jgobat/controller/README.md

# controller

Main control board for simple buoyancy driven underwater vehicles. Based around Teensy 3.6.
