jgobat/controller/kicad/floatController_Digikey_BOM.ods

Ref | Qnty | Value | Cmp name | Footprint | Description | Digikey
B1, | 1 | Battery_Cell | Battery_Cell | Battery:BatteryHolder_Keystone_3002_1x2032 | Single-cell battery | 36-3002-ND
C1, | G | 10u | C-EUC1210 | Capacitor_SMD:C_1206_3216Metric_Pad1.42x1.75mm_HandSolder |  | 490-4798-1-ND‎
C2, | 1 | 22u | C-EUC1210 | Capacitor_SMD:C_1206_3216Metric_Pad1.42x1.75mm_HandSolder |  | 490-4797-1-ND‎
C3, | 1 | 10u | C-EUC0805 | Capacitor_SMD:C_0805_2012Metric_Pad1.15x1.40mm_HandSolder |  | 490-10514-1-ND‎
C4, | 1 | 4.7u | C-EUC0805 | Capacitor_SMD:C_0603_1608Metric_Pad1.05x0.95mm_HandSolder |  | 490-16347-1-ND
C5, C6, C7, C8, C9, C10, C11, C12, C13, C15, C16, C17, C18, C20, C22, | 15 | 0.1u | C | Capacitor_SMD:C_0603_1608Metric_Pad1.05x0.95mm_HandSolder | Unpolarized capacitor | 490-16477-1-ND
C14, | 1 | 22u | C | Capacitor_SMD:C_0603_1608Metric_Pad1.05x0.95mm_HandSolder | Unpolarized capacitor | 490-13243-1-ND
C19, C23, | 2 | 10n | C | Capacitor_SMD:C_0603_1608Metric_Pad1.05x0.95mm_HandSolder | Unpolarized capacitor | 490-8028-1-ND
C21, | 1 | 39u | CP1 | Capacitor_SMD:CP_Elec_5x5.9 | Polarized capacitor, US symbol | P124997CT-ND
J1, | 1 | Molex_KK156_2 | MTA02-156 | Connector_Molex:Molex_KK-396_A-41791-0002_1x02_P3.96mm_Vertical |  | WM18823-ND
J2, J6, J9, | 3 | Molex_KK100_4 | Conn_01x04 | Connector_Molex:Molex_KK-254_AE-6410-04A_1x04_P2.54mm_Vertical | Generic connector, single row, 01x04, script generated (kicad-library-utils/schlib/autogen/connector/) | WM4202-ND
J3, J5, | 2 | Molex_KK100_6 | Conn_01x06 | Connector_Molex:Molex_KK-254_AE-6410-06A_1x06_P2.54mm_Vertical | Generic connector, single row, 01x06, script generated (kicad-library-utils/schlib/autogen/connector/) | WM4204-ND
J4, | 1 | Hirose_DF11_2x8 | Conn_01x16 | Connector_Hirose:Hirose_DF11-16DP-2DSA_2x08_P2.00mm_Vertical | Generic connector, single row, 01x16, script generated (kicad-library-utils/schlib/autogen/connector/) | H2856-ND
J7, | 1 | PinSocket_2.54mm_4 | Conn_01x04 | Connector_PinSocket_2.54mm:PinSocket_1x04_P2.54mm_Vertical | Generic connector, single row, 01x04, script generated (kicad-library-utils/schlib/autogen/connector/)
J8, J11, J14, | 3 | Molex_KK100_3 | Conn_01x03 | Connector_Molex:Molex_KK-254_AE-6410-03A_1x03_P2.54mm_Vertical | Generic connector, single row, 01x03, script generated (kicad-library-utils/schlib/autogen/connector/) | WM13451-ND
J10, | 1 | Molex_KK100_2 | Conn_01x02 | Connector_Molex:Molex_KK-254_AE-6410-02A_1x02_P2.54mm_Vertical | Generic connector, single row, 01x02, script generated (kicad-library-utils/schlib/autogen/connector/) | WM13450-ND
J12, | 1 | JST_SH_4_Horz | Conn_01x04 | Connector_JST:JST_SH_SM04B-SRSS-TB_1x04-1MP_P1.00mm_Horizontal | Generic connector, single row, 01x04, script generated (kicad-library-utils/schlib/autogen/connector/) | 455-1804-1-ND
J13, J15, | 2 | Hirose_DF11_2x2 | Conn_01x04 | Connector_Hirose:Hirose_DF11-4DP-2DSA_2x02_P2.00mm_Vertical | Generic connector, single row, 01x04, script generated (kicad-library-utils/schlib/autogen/connector/) | H122036-ND
J16, | 1 | Hirose_DF11_2x3 | Conn_01x06 | Connector_Hirose:Hirose_DF11-6DP-2DSA_2x03_P2.00mm_Vertical | Generic connector, single row, 01x06, script generated (kicad-library-utils/schlib/autogen/connector/) | H10230-ND
J17, | 1 | JST_SH_4_Vert | Conn_01x04 | Connector_JST:JST_SH_BM04B-SRSS-TB_1x04-1MP_P1.00mm_Vertical | Generic connector, single row, 01x04, script generated (kicad-library-utils/schlib/autogen/connector/) | 455-1790-1-ND
J18, | 1 | JST_SH_3_Vert | Conn_01x03 | Connector_JST:JST_SH_BM03B-SRSS-TB_1x03-1MP_P1.00mm_Vertical | Generic connector, single row, 01x03, script generated (kicad-library-utils/schlib/autogen/connector/) | 455-1789-1-ND
JP1, | 1 | PinHead_2.54mm_2 | PINHD-1X2 | Connector_PinHeader_2.54mm:PinHeader_1x02_P2.54mm_Vertical
JP2, JP3, JP4, JP5, JP6, JP7, JP8, JP9, JP12, JP13, | 10 | PinHead_2.54mm_3 | Conn_01x03_Male | Connector_PinHeader_2.54mm:PinHeader_1x03_P2.54mm_Vertical | Generic connector, single row, 01x03, script generated (kicad-library-utils/schlib/autogen/connector/)
JP10, JP11, JP14, | 3 | 0.003 0603 | Conn_01x03_Male | teensy_100:R0603_3position_jumper | Generic connector, single row, 01x03, script generated (kicad-library-utils/schlib/autogen/connector/)
MT1, MT2, MT3, MT4, | 4 | MountingHole | MountingHole | MountingHole:MountingHole_3mm_Pad | Mounting Hole without connection
Q1, | 1 | DMN3023L-7 | SI2334 | Package_TO_SOT_SMD:SOT-23 |  | DMN3023L-7DICT-ND
Q2, | 1 | SI4497 | SI4497 | Package_SO:SOIC-8_3.9x4.9mm_P1.27mm |  | SI4497DY-T1-GE3CT-ND
Q3, Q4, Q5, Q6, Q7, Q8, Q9, Q10, Q11, | 9 | Si4554DY | Si4532DY | Package_SO:SOIC-8_3.9x4.9mm_P1.27mm | 3.9A Id, 30V Vds, Dual N and P Channel MOSFET, 65mOhm Ron, 10V Vgs, SO8L | SI4554DY-T1-GE3CT-ND
Q12, | 1 | DMG6601LVT | DMC2053UVT | Package_TO_SOT_SMD:TSOT-23-6 | 4.6A/-3.2A Id, 20V Vds, Complementary pair enhancement mode P-Channel and N-Channel MOSFET, TSOT-23-6 | ‎DMG6601LVT-7DICT-ND‎
R1, | 1 | 0.025 | R_Shunt_US | Resistor_SMD:R_Shunt_Ohmite_LVK24 | Shunt resistor, US symbol | LVK24R025DERCT-ND
R2, R3, R4, R6, R7, R8, R9, R10, R11, R12, R13, R14, R15, R16, R17, R18, R19, R26, R27, R28, R29, R31, R32, R45, R46, | 25 | 220k | R_US | Resistor_SMD:R_0603_1608Metric_Pad1.05x0.95mm_HandSolder | Resistor, US symbol | P220KGCT-ND
R5, R38, R39, R40, R41, R42, R43, R44, | 8 | 10k | R_US | Resistor_SMD:R_0603_1608Metric_Pad1.05x0.95mm_HandSolder | Resistor, US symbol | P10KGCT-ND
R20, R21, R22, R23, R24, R25, | 6 | 4.7k | R_US | Resistor_SMD:R_0603_1608Metric_Pad1.05x0.95mm_HandSolder | Resistor, US symbol | P4.7KGCT-ND
R30, | 1 | 0.1 | R_US | Resistor_SMD:R_2512_6332Metric_Pad1.52x3.35mm_HandSolder | Resistor, US symbol | CSRN2512FTR100CT-ND
R33, R34, R35, | 3 | TBD | R_US | Resistor_SMD:R_0603_1608Metric_Pad1.05x0.95mm_HandSolder | Resistor, US symbol
SW1, | 1 | MS-106-3-x | REED-SWITCH-MK6-6 | teensy_100:MK6-6 |  | 2010-1085-ND
TP1, | 1 | +5V | TestPoint | TestPoint:TestPoint_Keystone_5000-5004_Miniature | test point | 36-5000-ND
TP2, | 1 | +3V3 | TestPoint | TestPoint:TestPoint_Keystone_5000-5004_Miniature | test point | 36-5000-ND
TP3, | 1 | GND | TestPoint | TestPoint:TestPoint_Keystone_5000-5004_Miniature | test point | 36-5001-ND
U1, | 1 | TEENSY_3.5_3.6 | TEENSY_3.5_3.6 | teensy_100:TEENSY_3.5_3.6 |  | 1568-1442-ND
U2, | 1 | TINY25 | TINY13PU | Package_DIP:DIP-8_W7.62mm_Socket |  | ATTINY25-20PU-ND
U3, | 1 | LMZM2360X | LMZM2360X | teensy_100:LMZM2360X |  | 296-49462-1-ND
U4, | 1 | TPSM842X | TPSM842X | teensy_100:TPSM842X |  | 296-47074-ND
U5, | 1 | INA233 | TI-INA226 | Package_SO:VSSOP-10_3x3mm_P0.5mm |  | 296-48136-1-ND
U6, U7, | 2 | MAX3221 | MAX3221 | Package_SO:SSOP-16_5.3x6.2mm_P0.65mm | RS232 transceiver with 15kV ESD protection | 296-9595-1-ND
U8, | 1 | LSM9DS1 | LSM9DS1 | Package_LGA:LGA-24L_3x3.5mm_P0.43mm |  | 497-14946-1-ND
U9, | 1 | BME280 | BME280 | Package_LGA:Bosch_LGA-8_2.5x2.5mm_P0.65mm_ClockwisePinNumbering |  | 828-1063-1-ND
U10, | 1 | LTC4311 | LTC4311 | Package_TO_SOT_SMD:SOT-363_SC-70-6_Handsoldering | Simple 2-wire bus buffer | LTC4311ISC6#TRMPBFCT-ND
U11, | 1 | ESP-07 | ESP-07 | teensy_100:ESP-07 | 802.11 b/g/n Wi-Fi Module | ESP-07S-ND
U12, | 1 | TPS709xx | TPS709xx | Package_TO_SOT_SMD:SOT-23-5 |  | ‎296-35483-1-ND‎
U13, U14, | 2 | TB67H451FNG | DRV8870DDA | Package_SO:Texas_HTSOP-8-1EP_3.9x4.9mm_P1.27mm_EP2.95x4.9mm_Mask2.4x3.1mm_ThermalVias | Brushed DC Motor Driver, PWM Control, 45V, 3.6A, Dynamic current limiting, HTSOP-8 | 264-TB67H451FNGELCT-ND
