jgobat/controller/kicad/floatController.kicad_pcb

## KiCad design kicad/floatController.kicad_pcb (2021-12-19)

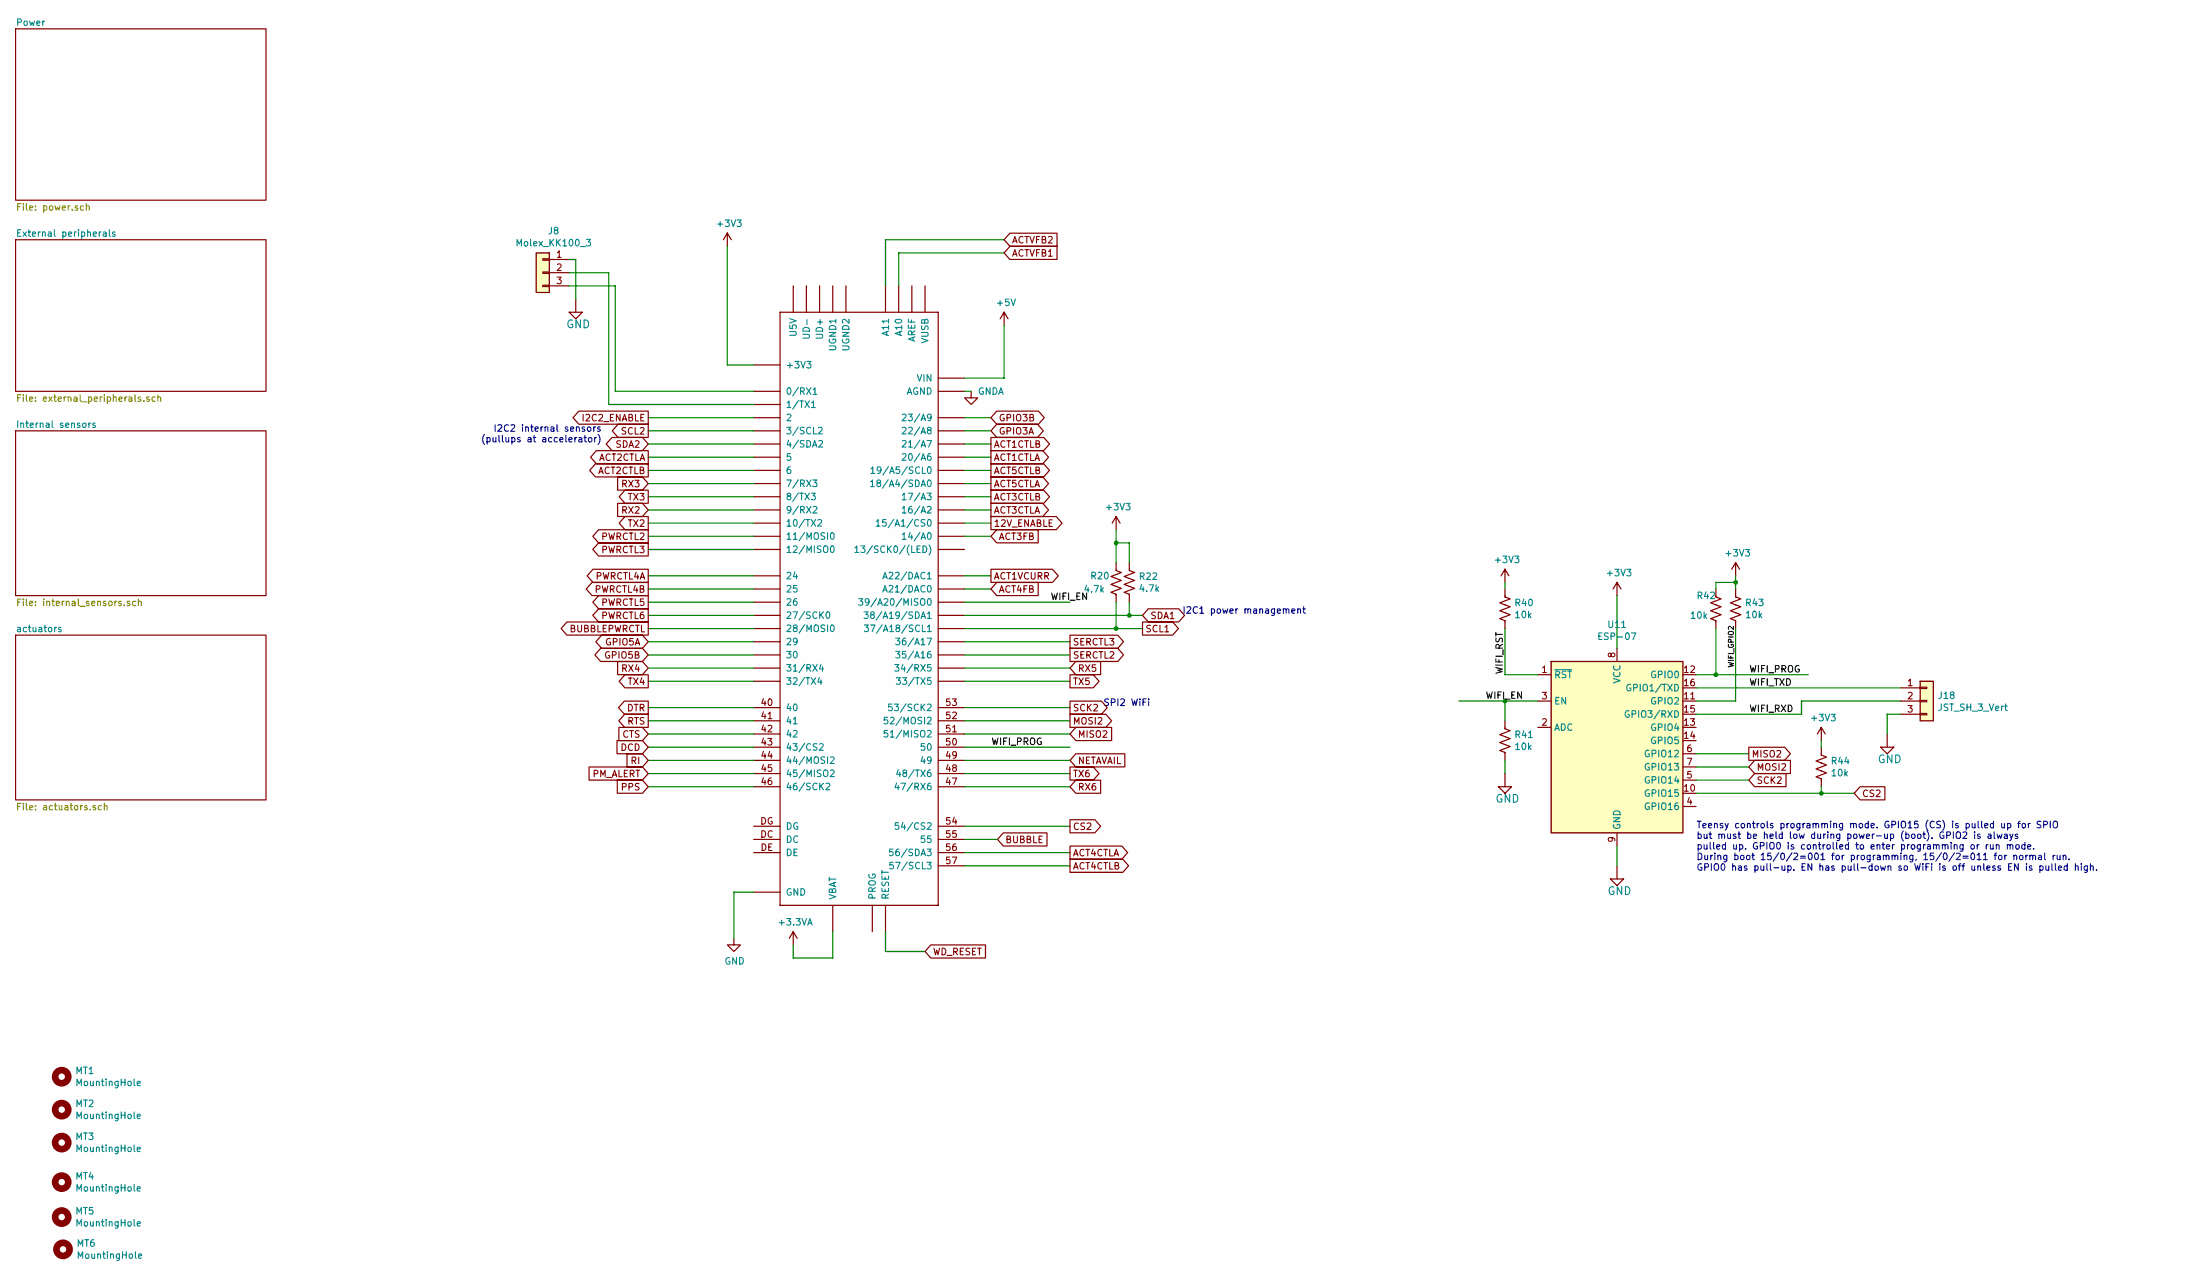
[picture p6: schematic floatController.sch, Float controller]

Parts:
J8: Molex_KK100_3; Molex_KK-254_AE-6410-03A_1x03_P2.54mm_Vertical; Manufacturer pn 0022235031; Digikey WM13451-ND
J18: JST_SH_3_Vert; JST_SH_BM03B-SRSS-TB_1x03-1MP_P1.00mm_Vertical; Manufacturer pn BM03B-SRSS-TB(LF)(SN); Digikey 455-1789-1-ND
MT1, MT2, MT3, MT4: MountingHole; MountingHole_3mm_Pad
MT5, MT6: MountingHole; MountingHole_2.5mm
R20, R22: 4.7k; R_0603_1608Metric_Pad1.05x0.95mm_HandSolder; Rating 5%, 1/10W; Manufacturer pn ERJ-3GEYJ472V; Digikey P4.7KGCT-ND
R40, R41, R42, R43, R44: 10k; R_0603_1608Metric_Pad1.05x0.95mm_HandSolder; Manufacturer pn ERJ-3GEYJ103V; Digikey P10KGCT-ND
U1: TEENSY_3.5_3.6; Digikey 1568-1442-ND
U11: ESP-07; Manufacturer pn ESP-07S; Digikey ESP-07S-ND

Connections:
12V_ENABLE: U1.15 (15/A1/CS0); also elsewhere on the board
+3.3VA: U1.VBAT; also elsewhere on the board
+3V3: R20.1, R22.1, R40.1, R42.1, R43.1, R44.1, U1.3V3 (+3V3), U1.3V3_2, U1.3V3_3, U1.3V3_LO, U11.8 (VCC); also elsewhere on the board
+5V: U1.VIN; also elsewhere on the board
/WIFI_EN: R41.1, U1.39 (39/A20/MISO0), U11.3 (EN)
/WIFI_GPIO2: R43.2, U11.11 (GPIO2)
/WIFI_PROG: R42.2, U1.50, U11.12 (GPIO0)
/WIFI_RST: R40.2, U11.1 (~RST)
/WIFI_RXD: J18.2, U11.15 (GPIO3/RXD)
/WIFI_TXD: J18.1, U11.16 (GPIO1/TXD)
ACT1CTLA: U1.20 (20/A6); also elsewhere on the board
ACT1CTLB: U1.21 (21/A7); also elsewhere on the board
ACT1VCURR: U1.A22 (A22/DAC1); also elsewhere on the board
ACT2CTLA: U1.5; also elsewhere on the board
ACT2CTLB: U1.6; also elsewhere on the board
ACT3CTLA: U1.16 (16/A2); also elsewhere on the board
ACT3CTLB: U1.17 (17/A3); also elsewhere on the board
ACT3FB: U1.14 (14/A0); also elsewhere on the board
ACT4CTLA: U1.56 (56/SDA3); also elsewhere on the board
ACT4CTLB: U1.57 (57/SCL3); also elsewhere on the board
ACT4FB: U1.A21 (A21/DAC0); also elsewhere on the board
ACT5CTLA: U1.18 (18/A4/SDA0); also elsewhere on the board
ACT5CTLB: U1.19 (19/A5/SCL0); also elsewhere on the board
ACTVFB1: U1.A10; also elsewhere on the board
ACTVFB2: U1.A11; also elsewhere on the board
BUBBLE: U1.55; also elsewhere on the board
BUBBLEPWRCTL: U1.28 (28/MOSI0); also elsewhere on the board
CS2: R44.2, U1.54 (54/CS2), U11.10 (GPIO15)
CTS: U1.42; also elsewhere on the board
DCD: U1.43 (43/CS2); also elsewhere on the board
DTR: U1.40; also elsewhere on the board
GND: J8.1, J18.3, R41.2, U1.GND, U1.GND2, U1.GND3, U1.GND4, U1.GND5, U11.9 (GND); also elsewhere on the board
GNDA: U1.AGND; also elsewhere on the board
GPIO3A: U1.22 (22/A8); also elsewhere on the board
GPIO3B: U1.23 (23/A9); also elsewhere on the board
GPIO5A: U1.29; also elsewhere on the board
GPIO5B: U1.30; also elsewhere on the board
I2C2_ENABLE: U1.2; also elsewhere on the board
MISO2: U1.51 (51/MISO2), U11.6 (GPIO12)
MOSI2: U1.52 (52/MOSI2), U11.7 (GPIO13)
NETAVAIL: U1.49; also elsewhere on the board
unnamed: J8.2, U1.1 (1/TX1)
unnamed: J8.3, U1.0 (0/RX1)
PM_ALERT: U1.45 (45/MISO2); also elsewhere on the board
PPS: U1.46 (46/SCK2); also elsewhere on the board
PWRCTL2: U1.11 (11/MOSI0); also elsewhere on the board
PWRCTL3: U1.12 (12/MISO0); also elsewhere on the board
PWRCTL4A: U1.24; also elsewhere on the board
PWRCTL4B: U1.25; also elsewhere on the board
PWRCTL5: U1.26; also elsewhere on the board
PWRCTL6: U1.27 (27/SCK0); also elsewhere on the board
RI: U1.44 (44/MOSI2); also elsewhere on the board
RTS: U1.41; also elsewhere on the board
RX2: U1.9 (9/RX2); also elsewhere on the board
RX3: U1.7 (7/RX3); also elsewhere on the board
RX4: U1.31 (31/RX4); also elsewhere on the board
RX5: U1.34 (34/RX5); also elsewhere on the board
RX6: U1.47 (47/RX6); also elsewhere on the board
SCK2: U1.53 (53/SCK2), U11.5 (GPIO14)
SCL1: R20.2, U1.37 (37/A18/SCL1); also elsewhere on the board
SCL2: U1.3 (3/SCL2); also elsewhere on the board
SDA1: R22.2, U1.38 (38/A19/SDA1); also elsewhere on the board
SDA2: U1.4 (4/SDA2); also elsewhere on the board
SERCTL2: U1.35 (35/A16); also elsewhere on the board
SERCTL3: U1.36 (36/A17); also elsewhere on the board
TX2: U1.10 (10/TX2); also elsewhere on the board
TX3: U1.8 (8/TX3); also elsewhere on the board
TX4: U1.32 (32/TX4); also elsewhere on the board
TX5: U1.33 (33/TX5); also elsewhere on the board
TX6: U1.48 (48/TX6); also elsewhere on the board
WD_RESET: U1.RESET; also elsewhere on the board

Notes on the sheet:
I2C1 power management
I2C2 internal sensors (pullups at accelerator)
SPI2 WiFi
Teensy controls programming mode. GPIO15 (CS) is pulled up for SPIO but must be held low during power-up (boot). GPIO2 is always pulled up. GPIO0 is controlled to enter programming or run mode. During boot 15/0/2=001 for programming, 15/0/2=011 for normal run. GPIO0 has pull-up. EN has pull-down so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

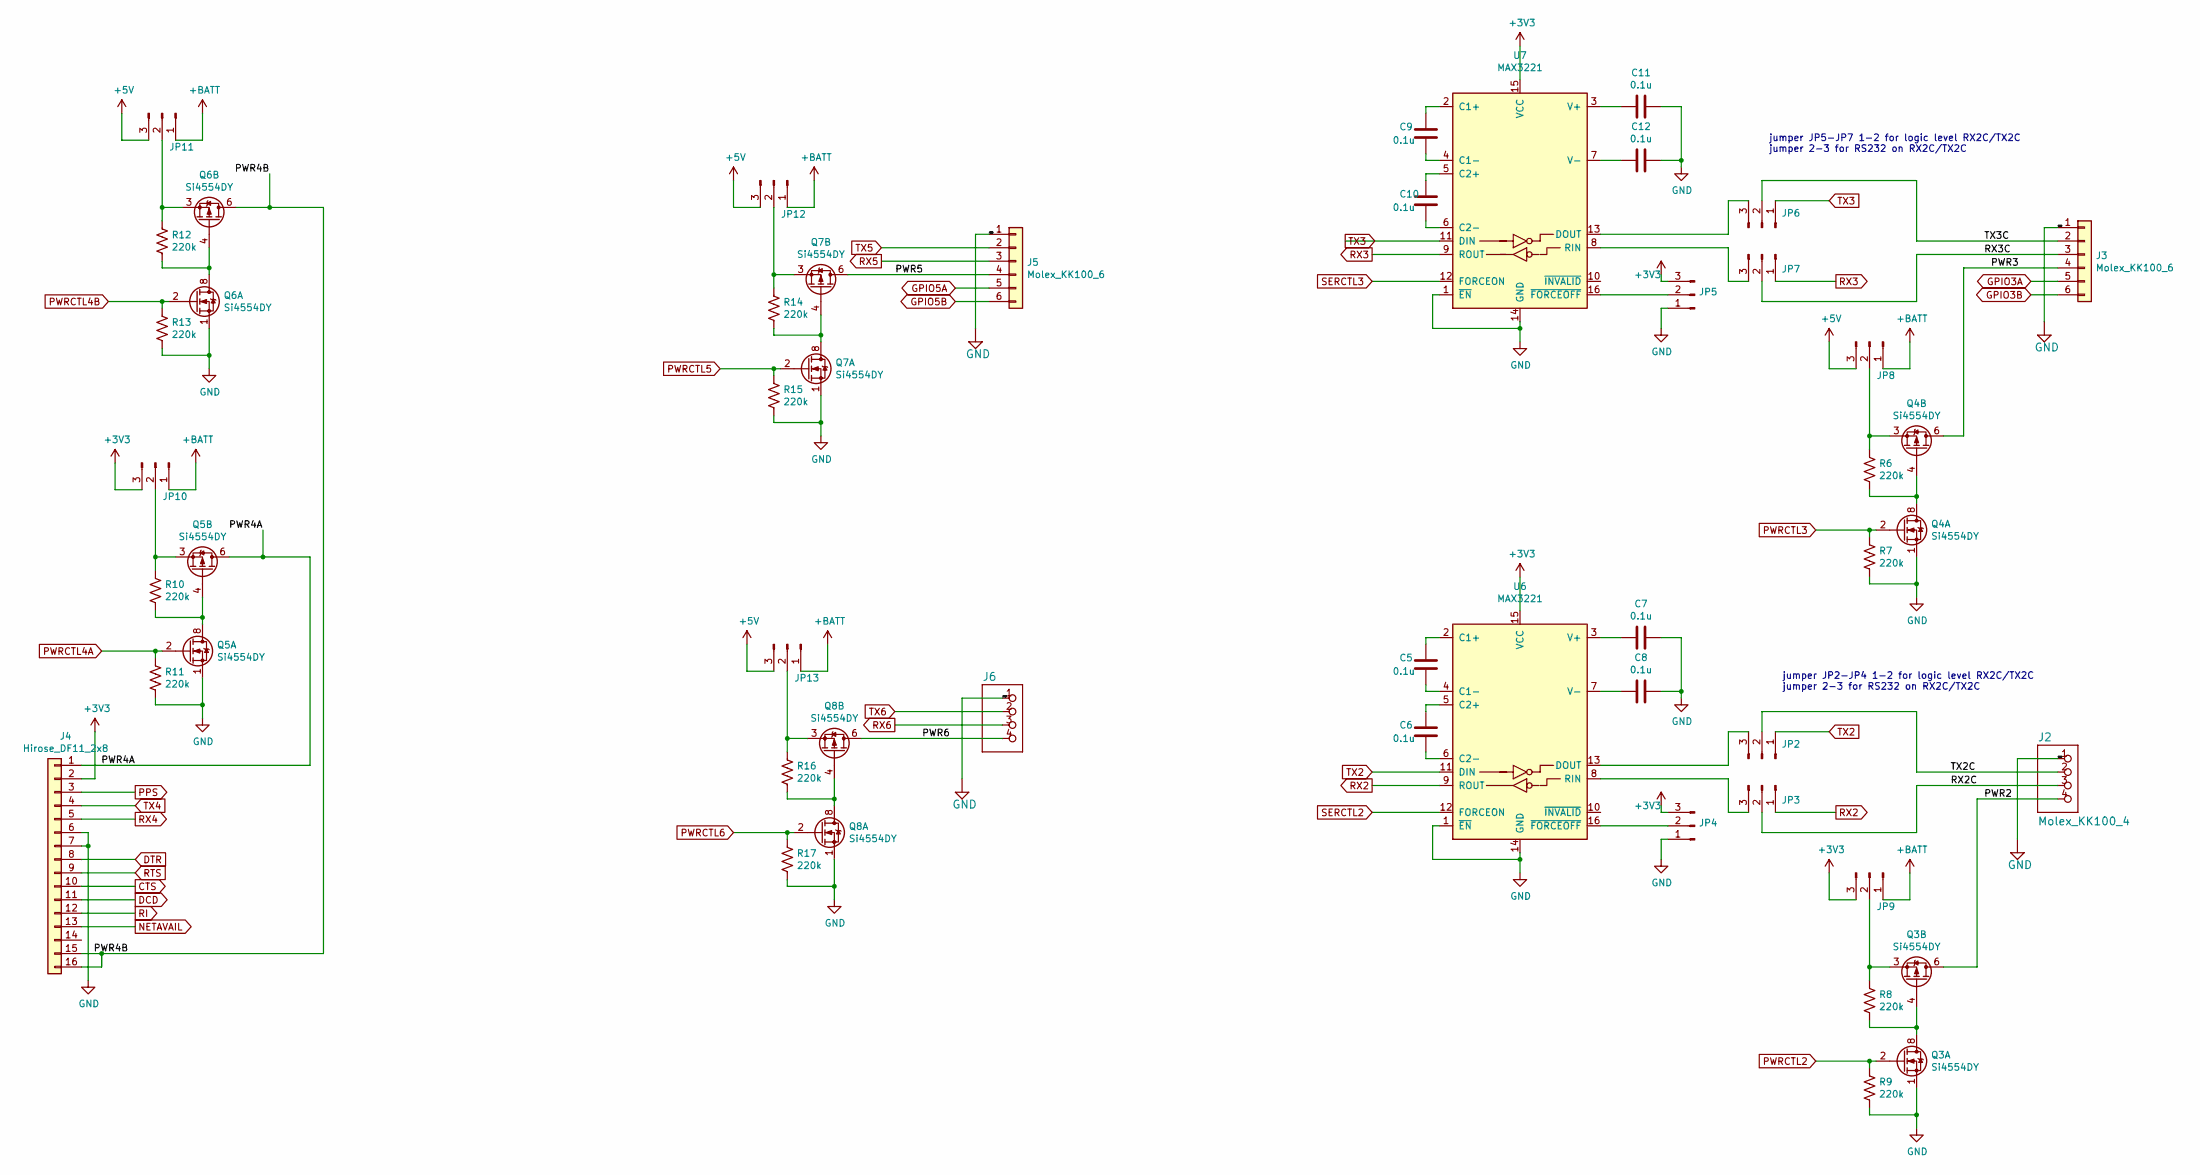
[picture p7: schematic external_peripherals.sch, Float controller]

Parts:
C5, C6, C7, C8, C9, C10, C11, C12: 0.1u; C_0603_1608Metric_Pad1.05x0.95mm_HandSolder; Manufacturer pn GCJ188R71E104KA12D‎; Digikey 490-16477-1-ND
J2, J6: Molex_KK100_4; Molex_KK-254_AE-6410-04A_1x04_P2.54mm_Vertical; Manufacturer pn 0022232041; Digikey WM4202-ND
J3, J5: Molex_KK100_6; Molex_KK-254_AE-6410-06A_1x06_P2.54mm_Vertical; Manufacturer pn 0022232061; Digikey WM4204-ND
J4: Hirose_DF11_2x8; Hirose_DF11-16DP-2DSA_2x08_P2.00mm_Vertical; Manufacturer pn DF11-16DP-2DSA(01); Digikey H2856-ND
JP2, JP3, JP4, JP5, JP6, JP7, JP8, JP9, JP12, JP13: PinHead_2.54mm_3; PinHeader_1x03_P2.54mm_Vertical
JP10: 0.003 0603; R0603_3position_jumper; Digikey 738-CSS0603FT3L00CT-ND
JP11: 0.003 0603; R0603_3position_jumper
Q3, Q4, Q5, Q6, Q7, Q8: Si4554DY; SOIC-8_3.9x4.9mm_P1.27mm; Manufacturer pn SI4554DY-T1-GE3; Digikey SI4554DY-T1-GE3CT-ND
R6, R7, R8, R9, R10, R11, R12, R13, R14, R15, R16, R17: 220k; R_0603_1608Metric_Pad1.05x0.95mm_HandSolder; Rating 5%, 1/10W; Manufacturer pn ERJ-3GEYJ224V; Digikey P220KGCT-ND
U6, U7: MAX3221; SSOP-16_5.3x6.2mm_P0.65mm; Manufacturer pn MAX3221IDBR; Digikey 296-9595-1-ND

Connections:
+3V3: J4.2, JP4.3, JP5.3, JP9.3, JP10.3, U6.15 (VCC), U7.15 (VCC); also elsewhere on the board
+5V: JP8.3, JP11.3, JP12.3, JP13.3; also elsewhere on the board
+BATT: JP8.1, JP9.1, JP10.1, JP11.1, JP12.1, JP13.1; also elsewhere on the board
/External peripherals/PWR2: J2.4, Q3.5 (D), Q3.6 (D)
/External peripherals/PWR3: J3.4, Q4.5 (D), Q4.6 (D)
/External peripherals/PWR4A: J4.1, Q5.5 (D), Q5.6 (D)
/External peripherals/PWR4B: J4.15, J4.16, Q6.5 (D), Q6.6 (D)
/External peripherals/PWR5: J5.4, Q7.5 (D), Q7.6 (D)
/External peripherals/PWR6: J6.4, Q8.5 (D), Q8.6 (D)
/External peripherals/RX2C: J2.3, JP3.2
/External peripherals/RX3C: J3.3, JP7.2
/External peripherals/TX2C: J2.2, JP2.2
/External peripherals/TX3C: J3.2, JP6.2
CTS: J4.10; also elsewhere on the board
DCD: J4.11; also elsewhere on the board
DTR: J4.8; also elsewhere on the board
GND: C7.1, C8.1, C11.1, C12.1, J2.1, J3.1, J4.6, J4.7, J5.1, J6.1, JP4.1, JP5.1, Q3.1 (S), Q4.1 (S), Q5.1 (S), Q6.1 (S), Q7.1 (S), Q8.1 (S), R7.2, R9.2, R11.2, R13.2, R15.2, R17.2, U6.1 (~EN), U6.14 (GND), U7.1 (~EN), U7.14 (GND); also elsewhere on the board
GPIO3A: J3.5; also elsewhere on the board
GPIO3B: J3.6; also elsewhere on the board
GPIO5A: J5.5; also elsewhere on the board
GPIO5B: J5.6; also elsewhere on the board
NETAVAIL: J4.13; also elsewhere on the board
unnamed: C5.1, U6.2 (C1+)
unnamed: C5.2, U6.4 (C1-)
unnamed: C6.1, U6.5 (C2+)
unnamed: C6.2, U6.6 (C2-)
unnamed: C7.2, U6.3 (V+)
unnamed: C8.2, U6.7 (V-)
unnamed: C9.1, U7.2 (C1+)
unnamed: C9.2, U7.4 (C1-)
unnamed: C10.1, U7.5 (C2+)
unnamed: C10.2, U7.6 (C2-)
unnamed: C11.2, U7.3 (V+)
unnamed: C12.2, U7.7 (V-)
unnamed: JP2.3, U6.13 (DOUT)
unnamed: JP3.3, U6.8 (RIN)
unnamed: JP4.2, U6.16 (~FORCEOFF)
unnamed: JP5.2, U7.16 (~FORCEOFF)
unnamed: JP6.3, U7.13 (DOUT)
unnamed: JP7.3, U7.8 (RIN)
unnamed: JP8.2, Q4.3 (1), R6.1
unnamed: JP9.2, Q3.3 (1), R8.1
unnamed: JP10.2, Q5.3 (1), R10.1
unnamed: JP11.2, Q6.3 (1), R12.1
unnamed: JP12.2, Q7.3 (1), R14.1
unnamed: JP13.2, Q8.3 (1), R16.1
unnamed: Q3.4 (G), Q3.7 (D), Q3.8 (D), R8.2
unnamed: Q4.4 (G), Q4.7 (D), Q4.8 (D), R6.2
unnamed: Q5.4 (G), Q5.7 (D), Q5.8 (D), R10.2
unnamed: Q6.4 (G), Q6.7 (D), Q6.8 (D), R12.2
unnamed: Q7.4 (G), Q7.7 (D), Q7.8 (D), R14.2
unnamed: Q8.4 (G), Q8.7 (D), Q8.8 (D), R16.2
PPS: J4.3; also elsewhere on the board
PWRCTL2: Q3.2 (G), R9.1; also elsewhere on the board
PWRCTL3: Q4.2 (G), R7.1; also elsewhere on the board
PWRCTL4A: Q5.2 (G), R11.1; also elsewhere on the board
PWRCTL4B: Q6.2 (G), R13.1; also elsewhere on the board
PWRCTL5: Q7.2 (G), R15.1; also elsewhere on the board
PWRCTL6: Q8.2 (G), R17.1; also elsewhere on the board
RI: J4.12; also elsewhere on the board
RTS: J4.9; also elsewhere on the board
RX2: JP3.1, U6.9 (ROUT); also elsewhere on the board
RX3: JP7.1, U7.9 (ROUT); also elsewhere on the board
RX4: J4.5; also elsewhere on the board
RX5: J5.3; also elsewhere on the board
RX6: J6.3; also elsewhere on the board
SERCTL2: U6.12 (FORCEON); also elsewhere on the board
SERCTL3: U7.12 (FORCEON); also elsewhere on the board
TX2: JP2.1, U6.11 (DIN); also elsewhere on the board
TX3: JP6.1, U7.11 (DIN); also elsewhere on the board
TX4: J4.4; also elsewhere on the board
TX5: J5.2; also elsewhere on the board
TX6: J6.2; also elsewhere on the board

Notes on the sheet:
jumper JP5-JP7 1-2 for logic level RX2C/TX2C jumper 2-3 for RS232 on RX2C/TX2C
jumper JP2-JP4 1-2 for logic level RX2C/TX2C jumper 2-3 for RS232 on RX2C/TX2C

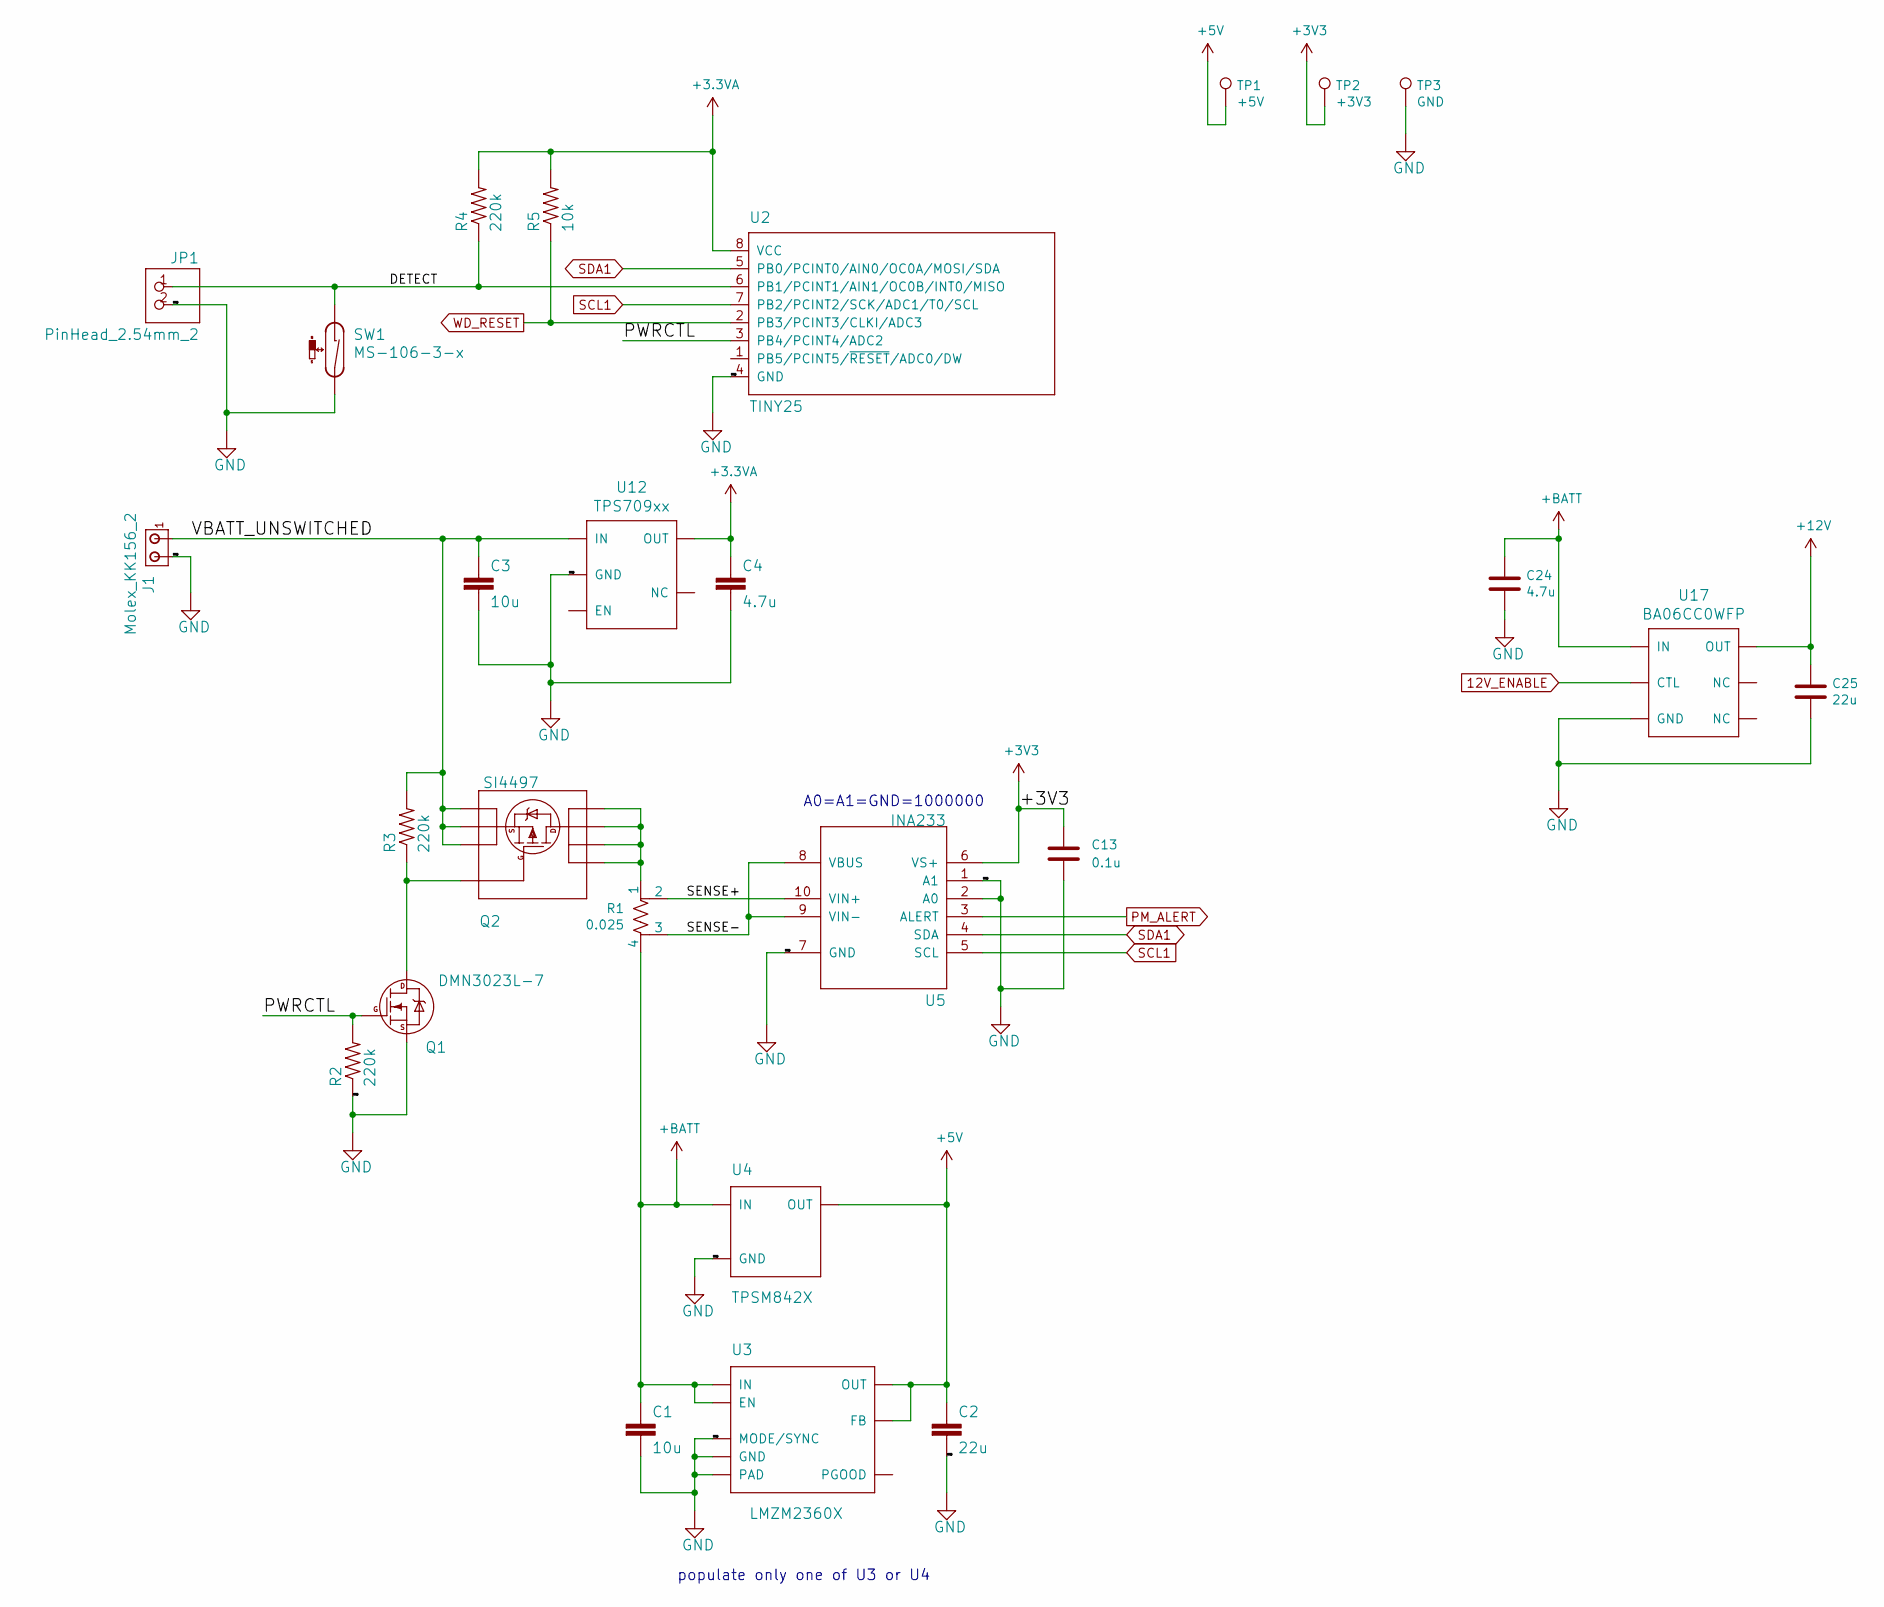
[picture p8: schematic power.sch, Float controller]

Parts:
C1: 10u; C_1206_3216Metric_Pad1.42x1.75mm_HandSolder; Rating 7.3u effective at 15V; Manufacturer pn ‎GCM32ER71E106KA57L‎; Digikey 490-4798-1-ND‎
C2: 22u; C_1206_3216Metric_Pad1.42x1.75mm_HandSolder; Rating 20u effective at 5V; Manufacturer pn ‎GCM32ER71A226KE12L‎; Digikey 490-4797-1-ND‎
C3: 10u; C_0805_2012Metric_Pad1.15x1.40mm_HandSolder; Rating 2.2u at 15V; Manufacturer pn GRM21BR6YA106KE43L‎; Digikey 490-10514-1-ND‎
C4: 4.7u; C_0603_1608Metric_Pad1.05x0.95mm_HandSolder; Rating 2.3u at 3.3V (min 1.5u for Vout > 1.5V); Manufacturer pn ‎GRM185R61C475ME11D; Digikey 490-16347-1-ND
C13: 0.1u; C_0603_1608Metric_Pad1.05x0.95mm_HandSolder; Manufacturer pn GCJ188R71E104KA12D‎; Digikey 490-16477-1-ND
C24: 4.7u; C_1206_3216Metric_Pad1.42x1.75mm_HandSolder; Rating 50V
C25: 22u; C_1210_3225Metric_Pad1.42x2.65mm_HandSolder; Rating 25V
J1: Molex_KK156_2; Molex_KK-396_A-41791-0002_1x02_P3.96mm_Vertical; Manufacturer pn ‎0009652028‎; Digikey WM18823-ND
JP1: PinHead_2.54mm_2; PinHeader_1x02_P2.54mm_Vertical
Q1: DMN3023L-7; SOT-23; Manufacturer pn DMN3023L-7; Digikey DMN3023L-7DICT-ND
Q2: SI4497; SOIC-8_3.9x4.9mm_P1.27mm; Manufacturer pn SI4497DY-T1-GE3; Digikey SI4497DY-T1-GE3CT-ND
R1: 0.025; R_Shunt_Ohmite_LVK24; Rating 0.5%, 1W (6A); Manufacturer pn LVK24R025DER; Digikey LVK24R025DERCT-ND
R2, R3, R4: 220k; R_0603_1608Metric_Pad1.05x0.95mm_HandSolder; Rating 5%, 1/10W; Manufacturer pn ERJ-3GEYJ224V; Digikey P220KGCT-ND
R5: 10k; R_0603_1608Metric_Pad1.05x0.95mm_HandSolder; Manufacturer pn ERJ-3GEYJ103V; Digikey P10KGCT-ND
SW1: MS-106-3-x; MK6-6; Rating 10-15AT (others available); Manufacturer pn MS-106-3-1; Digikey 2010-1085-ND
TP1: +5V; TestPoint_Keystone_5000-5004_Miniature; Manufacturer pn 5000; Digikey 36-5000-ND
TP2: +3V3; TestPoint_Keystone_5000-5004_Miniature; Manufacturer pn 5000; Digikey 36-5000-ND
TP3: GND; TestPoint_Keystone_5000-5004_Miniature; Manufacturer pn 5001; Digikey 36-5001-ND
U2: TINY25; DIP-8_W7.62mm_Socket; Rating 20MHz; Manufacturer pn ATTINY25-20PU; Digikey ATTINY25-20PU-ND
U3: LMZM2360X; Rating 4-36V, 1A, 28uA supply; Manufacturer pn LMZM23601V5SILT; Digikey 296-49462-1-ND
U4: TPSM842X; Rating 7-28V, 1.5A,; Manufacturer pn TPSM84205EAB; Digikey 296-47074-ND
U5: INA233; VSSOP-10_3x3mm_P0.5mm; Manufacturer pn INA233AIDGSR; Digikey 296-48136-1-ND
U12: TPS709xx; SOT-23-5; Rating 150mA, 30V max, 2.05uA quiescent; Manufacturer pn TPS70933DBVR; Digikey ‎296-35483-1-ND‎
U17: BA06CC0WFP; TO-252-5_TabPin6; Rating 1A, 25V max, 0uA shutdown; Manufacturer pn BA06CC0WFP-E2; Digikey BA06CC0WFP-E2CT-ND

Connections:
12V_ENABLE: U17.1 (CTL); also elsewhere on the board
+3.3VA: C4.1, R4.2, R5.2, U2.8 (VCC), U12.5 (OUT); also elsewhere on the board
+3V3: C13.1, TP2.1, U5.6 (VS+); also elsewhere on the board
+5V: C2.1, TP1.1, U3.6 (OUT), U3.7 (FB), U4.P$3 (OUT); also elsewhere on the board
+12V: C25.1, U17.4 (OUT); also elsewhere on the board
+BATT: C1.1, C24.1, R1.4, U3.3 (IN), U3.4 (EN), U4.P$1 (IN), U17.2 (IN); also elsewhere on the board
/Power/DETECT: JP1.1, R4.1, SW1.1, U2.6 (PB1/PCINT1/AIN1/OC0B/INT0/MISO)
/Power/PWRCTL: Q1.1 (G), R2.2, U2.3 (PB4/PCINT4/ADC2)
/Power/SENSE+: R1.2, U5.10 (VIN+)
/Power/SENSE-: R1.3, U5.8 (VBUS), U5.9 (VIN-)
/Power/VBATT_UNSWITCHED: C3.1, J1.1, Q2.1 (S@1), Q2.2 (S@2), Q2.3 (S@3), R3.2, U12.1 (IN)
GND: C1.2, C2.2, C3.2, C4.2, C13.2, C24.2, C25.2, J1.2, JP1.2, Q1.2 (S), R2.1, SW1.2, TP3.1, U2.4 (GND), U3.1 (GND), U3.2 (MODE/SYNC), U3.PAD, U4.P$2 (GND), U5.1 (A1), U5.2 (A0), U5.7 (GND), U12.2 (GND), U17.6 (GND); also elsewhere on the board
unnamed: Q1.3 (D), Q2.4 (G), R3.1
unnamed: Q2.5 (D@5), Q2.6 (D@6), Q2.7 (D@7), Q2.8 (D@8), R1.1
PM_ALERT: U5.3 (ALERT); also elsewhere on the board
SCL1: U2.7 (PB2/PCINT2/SCK/ADC1/T0/SCL), U5.5 (SCL); also elsewhere on the board
SDA1: U2.5 (PB0/PCINT0/AIN0/OC0A/MOSI/SDA), U5.4 (SDA); also elsewhere on the board
WD_RESET: R5.1, U2.2 (PB3/PCINT3/CLKI/ADC3); also elsewhere on the board

Notes on the sheet:
populate only one of U3 or U4
A0=A1=GND=1000000

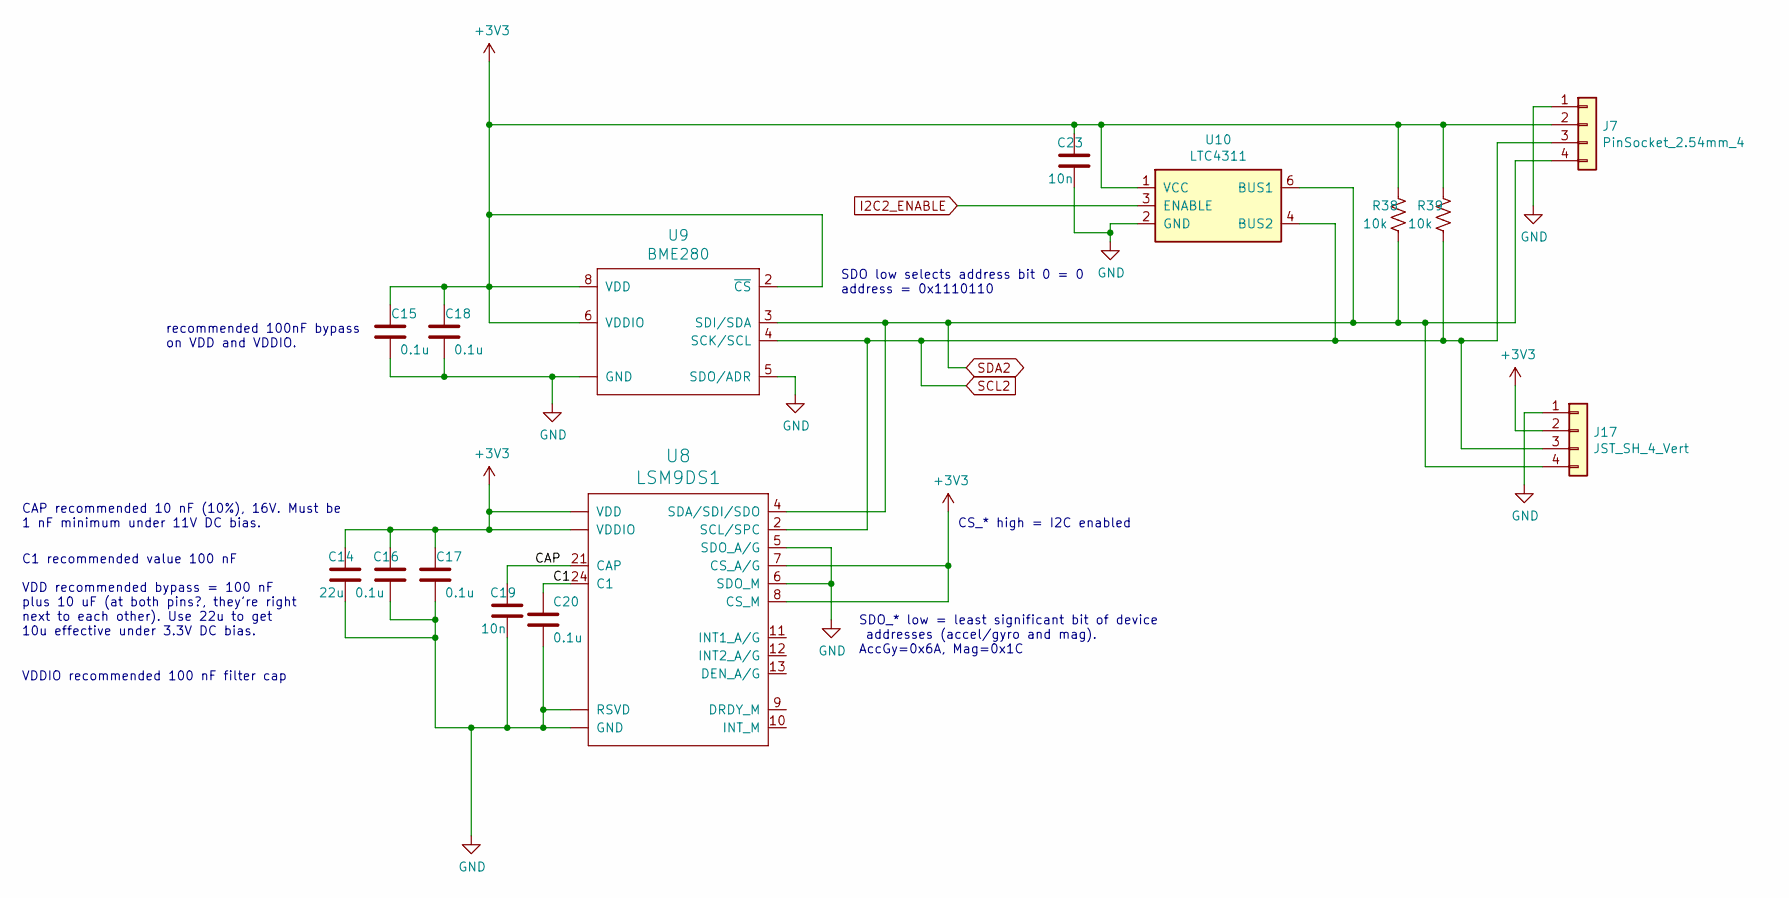
[picture p9: schematic internal_sensors.sch, Float controller]

Parts:
C14: 22u; C_0603_1608Metric_Pad1.05x0.95mm_HandSolder; Rating 10V rated, 9u effective at 3.3V; Manufacturer pn GRM187R61A226ME15D; Digikey 490-13243-1-ND
C15, C16, C17, C18, C20: 0.1u; C_0603_1608Metric_Pad1.05x0.95mm_HandSolder; Manufacturer pn GCJ188R71E104KA12D‎; Digikey 490-16477-1-ND
C19, C23: 10n; C_0603_1608Metric_Pad1.05x0.95mm_HandSolder; Manufacturer pn ‎GCM188R72A103KA37J‎; Digikey 490-8028-1-ND
J7: PinSocket_2.54mm_4; PinSocket_1x04_P2.54mm_Vertical
J17: JST_SH_4_Vert; JST_SH_BM04B-SRSS-TB_1x04-1MP_P1.00mm_Vertical; Manufacturer pn BM04B-SRSS-TB(LF)(SN); Digikey 455-1790-1-ND
R38, R39: 10k; R_0603_1608Metric_Pad1.05x0.95mm_HandSolder; Manufacturer pn ERJ-3GEYJ103V; Digikey P10KGCT-ND
U8: LSM9DS1; LGA-24L_3x3.5mm_P0.43mm; Manufacturer pn LSM9DS1TR; Digikey 497-14946-1-ND
U9: BME280; Bosch_LGA-8_2.5x2.5mm_P0.65mm_ClockwisePinNumbering; Manufacturer pn BME280; Digikey 828-1063-1-ND
U10: LTC4311; SOT-363_SC-70-6_Handsoldering; Manufacturer pn LTC4311ISC6#TRMPBF; Digikey LTC4311ISC6#TRMPBFCT-ND

Connections:
+3V3: C14.1, C15.1, C16.1, C17.1, C18.1, C23.1, J7.2, J17.2, R38.1, R39.1, U8.1 (VDDIO), U8.3 (VDDIO), U8.7 (CS_A/G), U8.8 (CS_M), U8.22 (VDD), U8.23 (VDD), U9.2 (~CS), U9.6 (VDDIO), U9.8 (VDD), U10.1 (VCC); also elsewhere on the board
/Internal sensors/C1: C20.1, U8.24 (C1)
/Internal sensors/CAP: C19.1, U8.21 (CAP)
GND: C14.2, C15.2, C16.2, C17.2, C18.2, C19.2, C20.2, C23.2, J7.1, J17.1, U8.5 (SDO_A/G), U8.6 (SDO_M), U8.14 (RSVD), U8.15 (RSVD), U8.16 (RSVD), U8.17 (RSVD), U8.18 (RSVD), U8.19 (GND), U8.20 (GND), U9.1 (GND), U9.5 (SDO/ADR), U9.7 (GND), U10.2 (GND), U10.5 (GND); also elsewhere on the board
I2C2_ENABLE: U10.3 (ENABLE); also elsewhere on the board
SCL2: J7.3, J17.3, R39.2, U8.2 (SCL/SPC), U9.4 (SCK/SCL), U10.4 (BUS2); also elsewhere on the board
SDA2: J7.4, J17.4, R38.2, U8.4 (SDA/SDI/SDO), U9.3 (SDI/SDA), U10.6 (BUS1); also elsewhere on the board

Notes on the sheet:
CS_* high = I2C enabled
SDO_* low = least significant bit of device addresses (accel/gyro and mag). AccGy=0x6A, Mag=0x1C
CAP recommended 10 nF (10%), 16V. Must be 1 nF minimum under 11V DC bias.
C1 recommended value 100 nF
VDD recommended bypass = 100 nF plus 10 uF (at both pins?, they're right next to each other). Use 22u to get 10u effective under 3.3V DC bias.
VDDIO recommended 100 nF filter cap
recommended 100nF bypass on VDD and VDDIO.
SDO low selects address bit 0 = 0 address = 0x1110110
