jgobat/controller/kicad/floatController.kicad_pcb

## KiCad design kicad/floatController.kicad_pcb (continued)

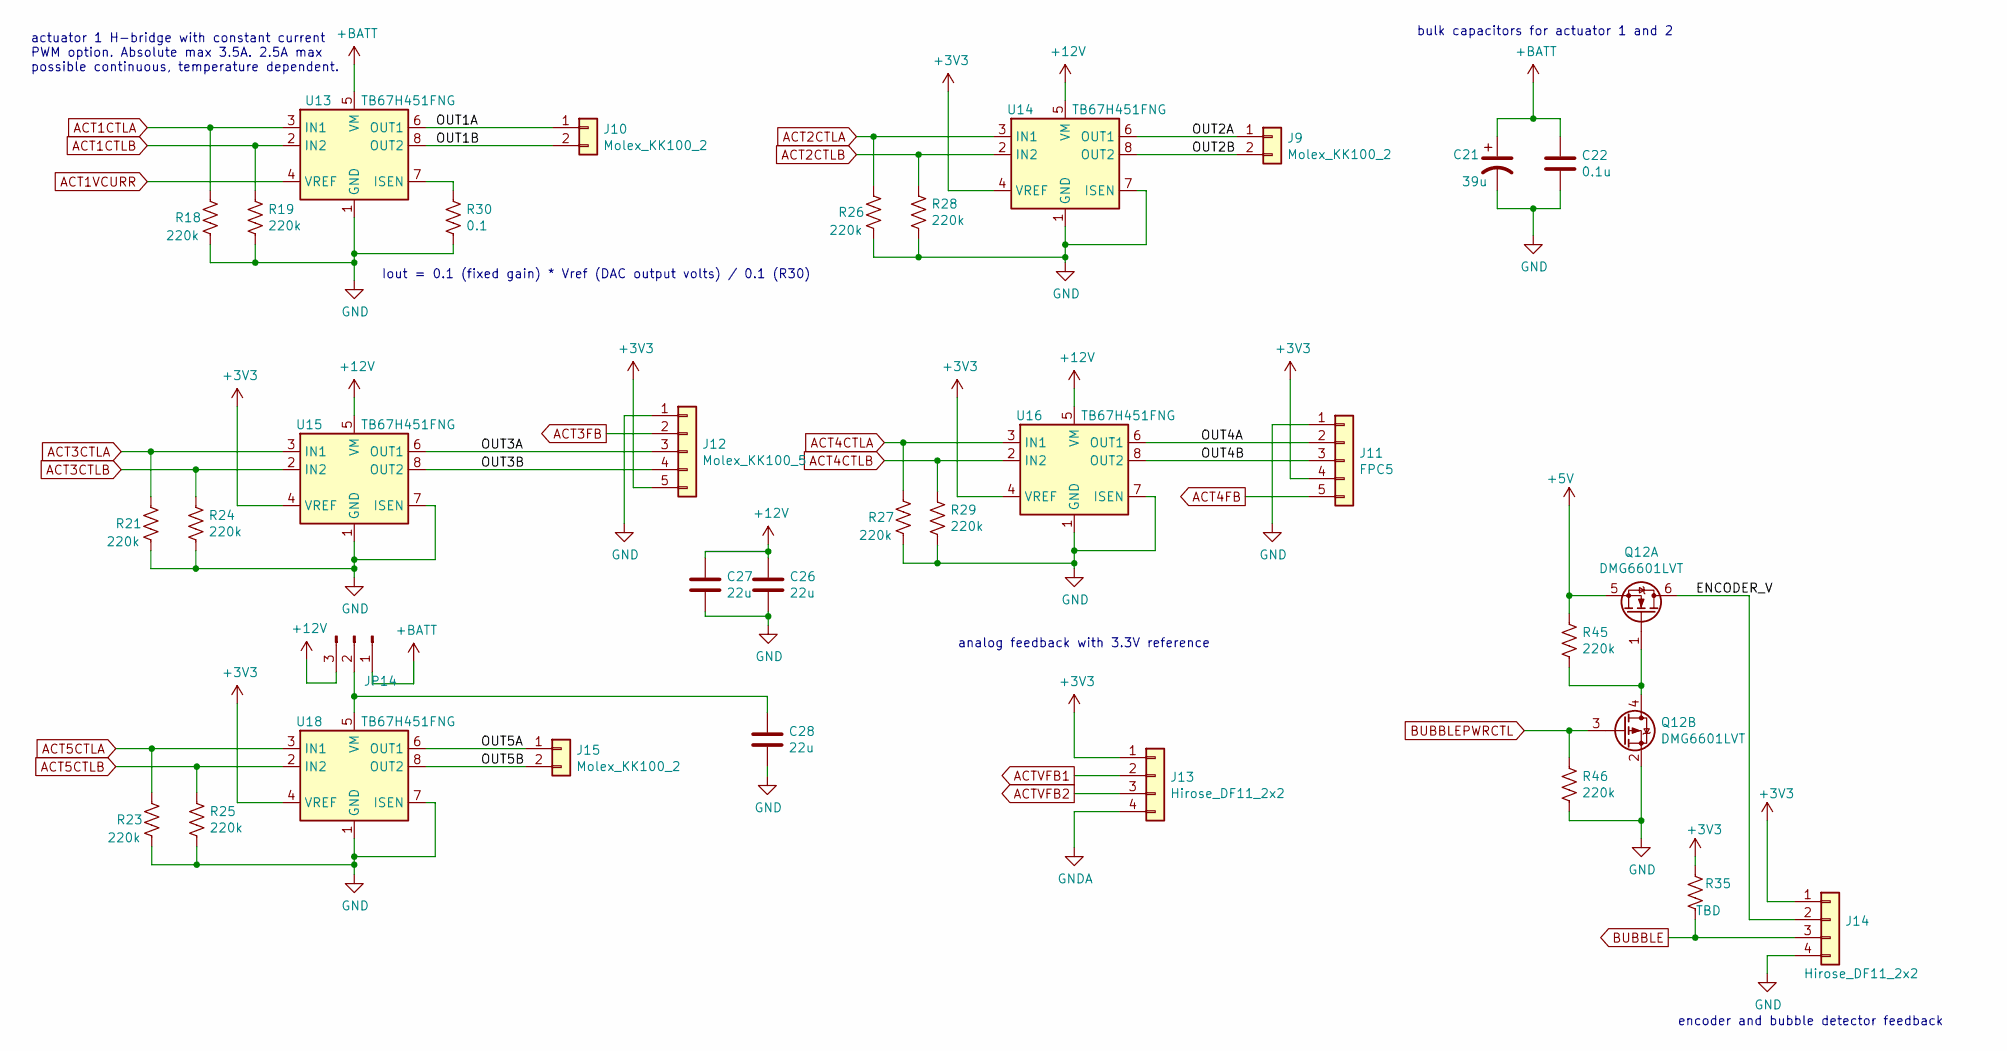
[picture p10: schematic actuators.sch]

Parts:
C21: 39u; CP_Elec_5x5.9; Manufacturer pn EEH-ZK1V390UR‎; Digikey P124997CT-ND
C22: 0.1u; C_0603_1608Metric_Pad1.05x0.95mm_HandSolder; Manufacturer pn GCJ188R71E104KA12D‎; Digikey 490-16477-1-ND
C26, C27, C28: 22u; C_1210_3225Metric_Pad1.42x2.65mm_HandSolder; Rating 25V
J9, J10, J15: Molex_KK100_2; Molex_KK-254_AE-6410-02A_1x02_P2.54mm_Vertical; Manufacturer pn 0022235021; Digikey WM13450-ND
J11: FPC5; Molex_200528-0050_1x05-1MP_P1.00mm_Horizontal
J12: Molex_KK100_5; Molex_KK-254_AE-6410-05A_1x05_P2.54mm_Vertical
J13, J14: Hirose_DF11_2x2; Hirose_DF11-4DP-2DSA_2x02_P2.00mm_Vertical; Manufacturer pn DF11-4DP-2DSA(08); Digikey H122036-ND
JP14: PinHead_2.54mm_3; PinHeader_1x03_P2.54mm_Vertical
Q12: DMG6601LVT; TSOT-23-6; Digikey ‎DMG6601LVT-7DICT-ND‎
R18, R19, R21, R23, R24, R25, R26, R27, R28, R29, R45, R46: 220k; R_0603_1608Metric_Pad1.05x0.95mm_HandSolder; Rating 5%, 1/10W; Manufacturer pn ERJ-3GEYJ224V; Digikey P220KGCT-ND
R30: 0.1; R_2512_6332Metric_Pad1.52x3.35mm_HandSolder; Rating 1%, 2W (4A); Manufacturer pn CSRN2512FTR100; Digikey CSRN2512FTR100CT-ND
R35: TBD; R_0603_1608Metric_Pad1.05x0.95mm_HandSolder
U13, U14, U15, U16, U18: TB67H451FNG; Texas_HTSOP-8-1EP_3.9x4.9mm_P1.27mm_EP2.95x4.9mm_Mask2.4x3.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; Rating 3A, pin compatible with DRV8870 with lo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; Manufacturer pn TB67H451FNG,EL; Digikey 264-TB67H451FNGELCT-ND

Connections:
+3V3: J11.4, J12.5, J13.1, J14.1, R35.1, U14.4 (VREF), U15.4 (VREF), U16.4 (VREF), U18.4 (VREF); also elsewhere on the board
+5V: Q12.5 (S), R45.1; also elsewhere on the board
+12V: C26.1, C27.1, JP14.3, U14.5 (VM), U15.5 (VM), U16.5 (VM); also elsewhere on the board
+BATT: C21.1, C22.1, JP14.1, U13.5 (VM); also elsewhere on the board
/actuators/ENCODER_V: J14.2, Q12.6 (D)
/actuators/OUT1A: J10.1, U13.6 (OUT1)
/actuators/OUT1B: J10.2, U13.8 (OUT2)
/actuators/OUT2A: J9.1, U14.6 (OUT1)
/actuators/OUT2B: J9.2, U14.8 (OUT2)
/actuators/OUT3A: J12.3, U15.6 (OUT1)
/actuators/OUT3B: J12.4, U15.8 (OUT2)
/actuators/OUT4A: J11.2, U16.6 (OUT1)
/actuators/OUT4B: J11.3, U16.8 (OUT2)
/actuators/OUT5A: J15.1, U18.6 (OUT1)
/actuators/OUT5B: J15.2, U18.8 (OUT2)
ACT1CTLA: R18.1, U13.3 (IN1); also elsewhere on the board
ACT1CTLB: R19.1, U13.2 (IN2); also elsewhere on the board
ACT1VCURR: U13.4 (VREF); also elsewhere on the board
ACT2CTLA: R26.1, U14.3 (IN1); also elsewhere on the board
ACT2CTLB: R28.1, U14.2 (IN2); also elsewhere on the board
ACT3CTLA: R21.1, U15.3 (IN1); also elsewhere on the board
ACT3CTLB: R24.1, U15.2 (IN2); also elsewhere on the board
ACT3FB: J12.2; also elsewhere on the board
ACT4CTLA: R27.1, U16.3 (IN1); also elsewhere on the board
ACT4CTLB: R29.1, U16.2 (IN2); also elsewhere on the board
ACT4FB: J11.5; also elsewhere on the board
ACT5CTLA: R23.1, U18.3 (IN1); also elsewhere on the board
ACT5CTLB: R25.1, U18.2 (IN2); also elsewhere on the board
ACTVFB1: J13.2; also elsewhere on the board
ACTVFB2: J13.3; also elsewhere on the board
BUBBLE: J14.3, R35.2; also elsewhere on the board
BUBBLEPWRCTL: Q12.3 (G), R46.1; also elsewhere on the board
GND: C21.2, C22.2, C26.2, C27.2, C28.2, J11.1, J12.1, J14.4, Q12.2 (S), R18.2, R19.2, R21.2, R23.2, R24.2, R25.2, R26.2, R27.2, R28.2, R29.2, R30.2, R46.2, U13.1 (GND), U13.9 (GND), U14.1 (GND), U14.7 (ISEN), U14.9 (GND), U15.1 (GND), U15.7 (ISEN), U15.9 (GND), U16.1 (GND), U16.7 (ISEN), U16.9 (GND), U18.1 (GND), U18.7 (ISEN), U18.9 (GND); also elsewhere on the board
GNDA: J13.4; also elsewhere on the board
unnamed: C28.1, JP14.2, U18.5 (VM)
unnamed: Q12.1 (G), Q12.4 (D), R45.2
unnamed: R30.1, U13.7 (ISEN)

Notes on the sheet:
analog feedback with 3.3V reference
encoder and bubble detector feedback
actuator 1 H-bridge with constant current PWM option. Absolute max 3.5A. 2.5A max possible continuous, temperature dependent.
bulk capacitors for actuator 1 and 2
Iout = 0.1 (fixed gain) * Vref (DAC output volts) / 0.1 (R30)

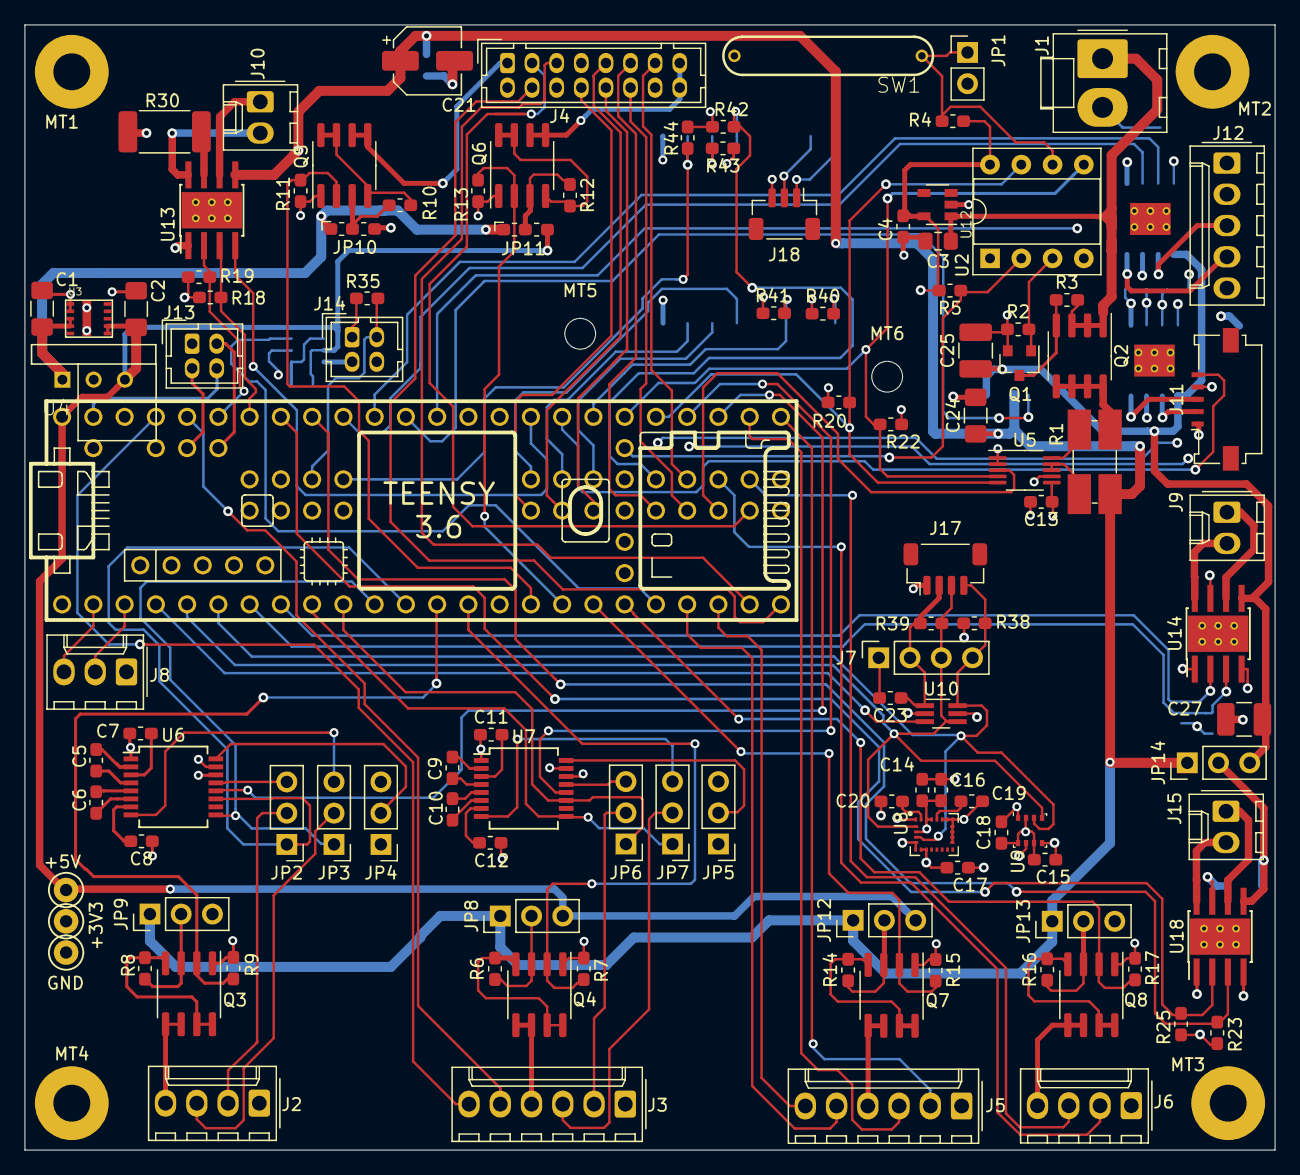
[picture p11: board floatController.kicad_pcb from above]

Board: 4 copper layers, 101.6 x 91.4 mm, 136 parts (0 on the bottom side), 136 nets.
